vroland/epd-laptop/thinkpad-keyboard/thinkpad-keyboard/thinkpad-keyboard.kicad_pcb

## KiCad design thinkpad-keyboard/thinkpad-keyboard/thinkpad-keyboard.kicad_pcb (2020-07-27)

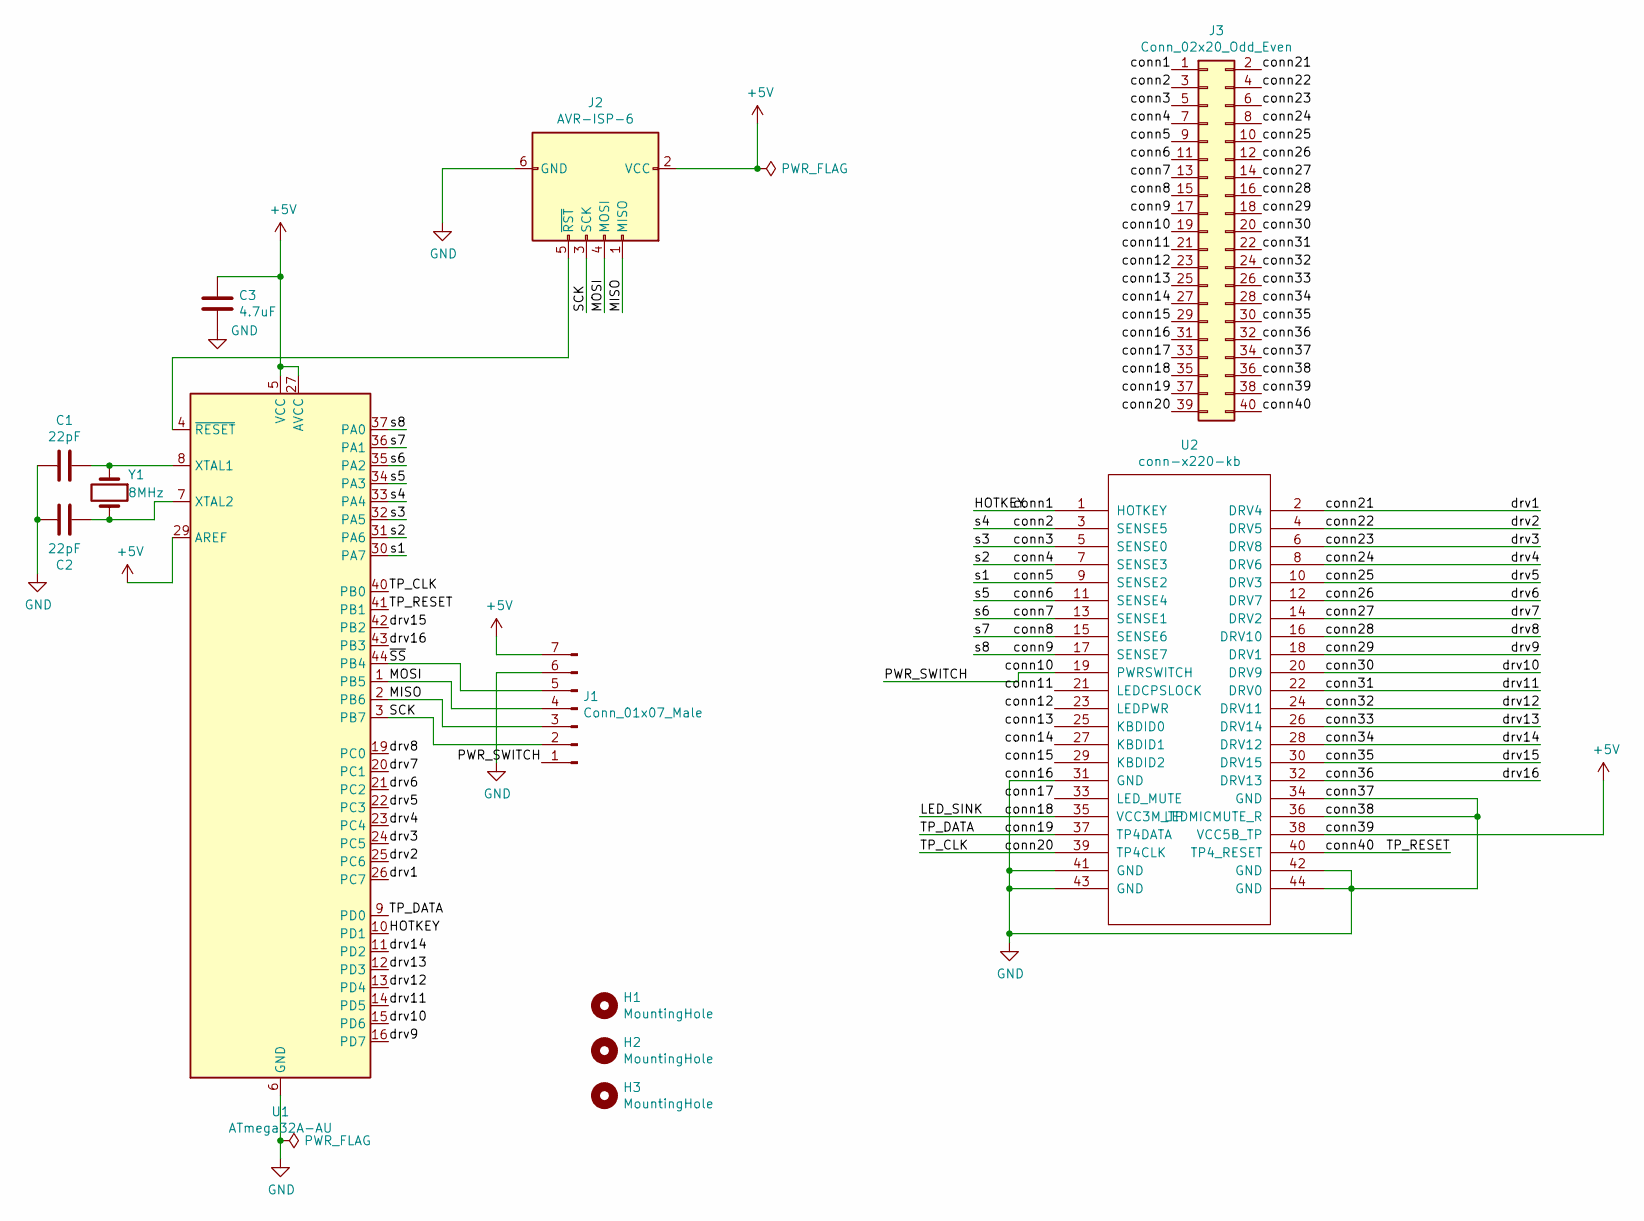
[picture p1: schematic thinkpad-keyboard.sch]

Parts:
C1, C2: 22pF; C_0603_1608Metric
C3: 4.7uF; C_0603_1608Metric
H1, H2, H3: MountingHole; MountingHole_2.2mm_M2
J1: Conn_01x07_Male; PinHeader_1x07_P2.54mm_Vertical
J2: AVR-ISP-6; PinHeader_2x03_P2.54mm_Vertical
J3: Conn_02x20_Odd_Even; PinHeader_2x20_P2.54mm_Vertical
U1: ATmega32A-AU; TQFP-44_10x10mm_P0.8mm
U2: conn-x220-kb; AA01B-S040VA1
Y1: 8MHz; Crystal_SMD_5032-2Pin_5.0x3.2mm

Connections:
+5V: C3.2, J1.7, J2.2 (VCC), J3.38, U1.5 (VCC), U1.17 (VCC), U1.27 (AVCC), U1.29 (AREF), U1.38 (VCC), U2.38 (VCC5B_TP)
/HOTKEY: J3.1, U1.10 (PD1), U2.1 (HOTKEY)
/LED_SINK: J3.35, U2.35 (VCC3M_TP)
/MISO: J1.3, J2.1 (MISO), U1.2 (PB6)
/MOSI: J1.4, J2.4 (MOSI), U1.1 (PB5)
/PWR_SWITCH: J1.1, J3.19, U2.19 (PWRSWITCH)
/SCK: J1.2, J2.3 (SCK), U1.3 (PB7)
/TP_CLK: J3.39, U1.40 (PB0), U2.39 (TP4CLK)
/TP_DATA: J3.37, U1.9 (PD0), U2.37 (TP4DATA)
/TP_RESET: J3.40, U1.41 (PB1), U2.40 (TP4_RESET)
/conn2: J3.3, U1.33 (PA4), U2.3 (SENSE5)
/conn3: J3.5, U1.32 (PA5), U2.5 (SENSE0)
/conn4: J3.7, U1.31 (PA6), U2.7 (SENSE3)
/conn5: J3.9, U1.30 (PA7), U2.9 (SENSE2)
/conn6: J3.11, U1.34 (PA3), U2.11 (SENSE4)
/conn7: J3.13, U1.35 (PA2), U2.13 (SENSE1)
/conn8: J3.15, U1.36 (PA1), U2.15 (SENSE6)
/conn9: J3.17, U1.37 (PA0), U2.17 (SENSE7)
/conn11: J3.21, U2.21 (LEDCPSLOCK)
/conn12: J3.23, U2.23 (LEDPWR)
/conn13: J3.25, U2.25 (KBDID0)
/conn14: J3.27, U2.27 (KBDID1)
/conn15: J3.29, U2.29 (KBDID2)
/conn17: J3.33, U2.33 (LED_MUTE)
/conn21: J3.2, U1.26 (PC7), U2.2 (DRV4)
/conn22: J3.4, U1.25 (PC6), U2.4 (DRV5)
/conn23: J3.6, U1.24 (PC5), U2.6 (DRV8)
/conn24: J3.8, U1.23 (PC4), U2.8 (DRV6)
/conn25: J3.10, U1.22 (PC3), U2.10 (DRV3)
/conn26: J3.12, U1.21 (PC2), U2.12 (DRV7)
/conn27: J3.14, U1.20 (PC1), U2.14 (DRV2)
/conn28: J3.16, U1.19 (PC0), U2.16 (DRV10)
/conn29: J3.18, U1.16 (PD7), U2.18 (DRV1)
/conn30: J3.20, U1.15 (PD6), U2.20 (DRV9)
/conn31: J3.22, U1.14 (PD5), U2.22 (DRV0)
/conn32: J3.24, U1.13 (PD4), U2.24 (DRV11)
/conn33: J3.26, U1.12 (PD3), U2.26 (DRV14)
/conn34: J3.28, U1.11 (PD2), U2.28 (DRV12)
/conn35: J3.30, U1.42 (PB2), U2.30 (DRV15)
/conn36: J3.32, U1.43 (PB3), U2.32 (DRV13)
/~SS: J1.5, U1.44 (PB4)
GND: C1.2, C2.1, C3.1, J1.6, J2.6 (GND), J3.31, J3.34, J3.36, U1.6 (GND), U1.18 (GND), U1.28 (GND), U1.39 (GND), U2.31 (GND), U2.34 (GND), U2.36 (LEDMICMUTE_R), U2.41 (GND), U2.42 (GND), U2.43 (GND), U2.44 (GND)
unnamed: C1.1, U1.8 (XTAL1), Y1.1
unnamed: C2.2, U1.7 (XTAL2), Y1.2
unnamed: J2.5 (~RST), U1.4 (~RESET)

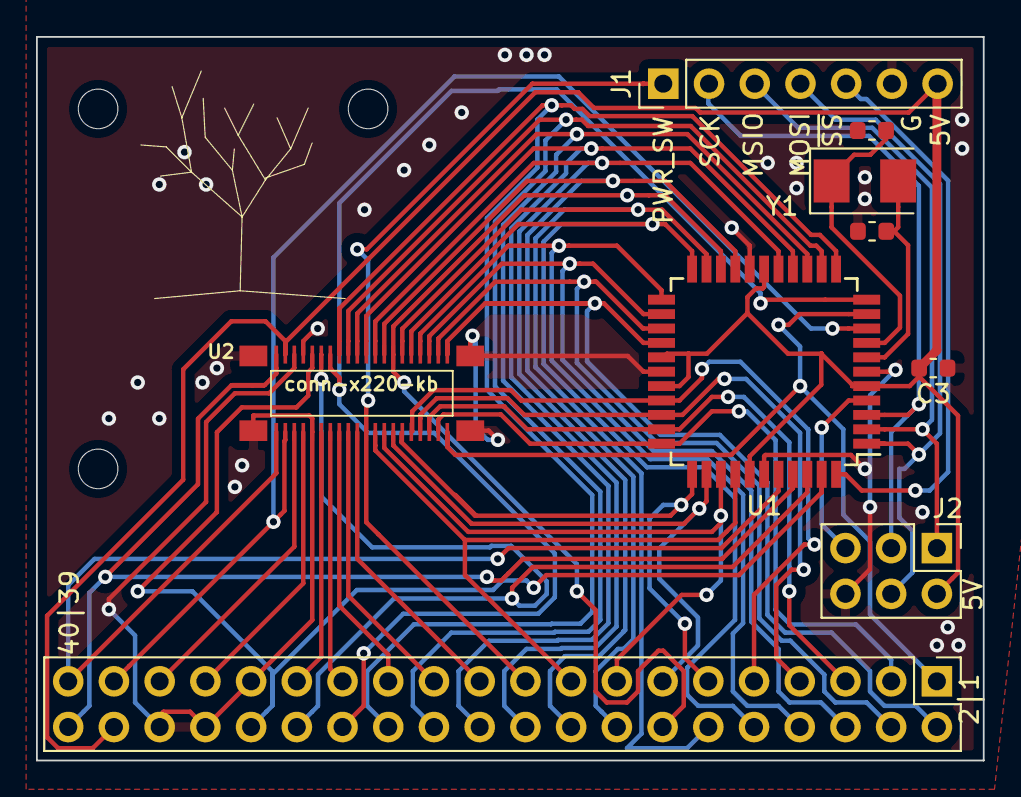
[picture p2: board thinkpad-keyboard.kicad_pcb from above]

Board: 2 copper layers, 52.6 x 40.2 mm, 12 parts (0 on the bottom side), 45 nets.
